smashsmashin/ROTAX-CAN-decoder/hw/BRP-RotaxEngineDecoder.kicad_sch

## KiCad design hw/BRP-RotaxEngineDecoder.kicad_sch (2025-06-22)

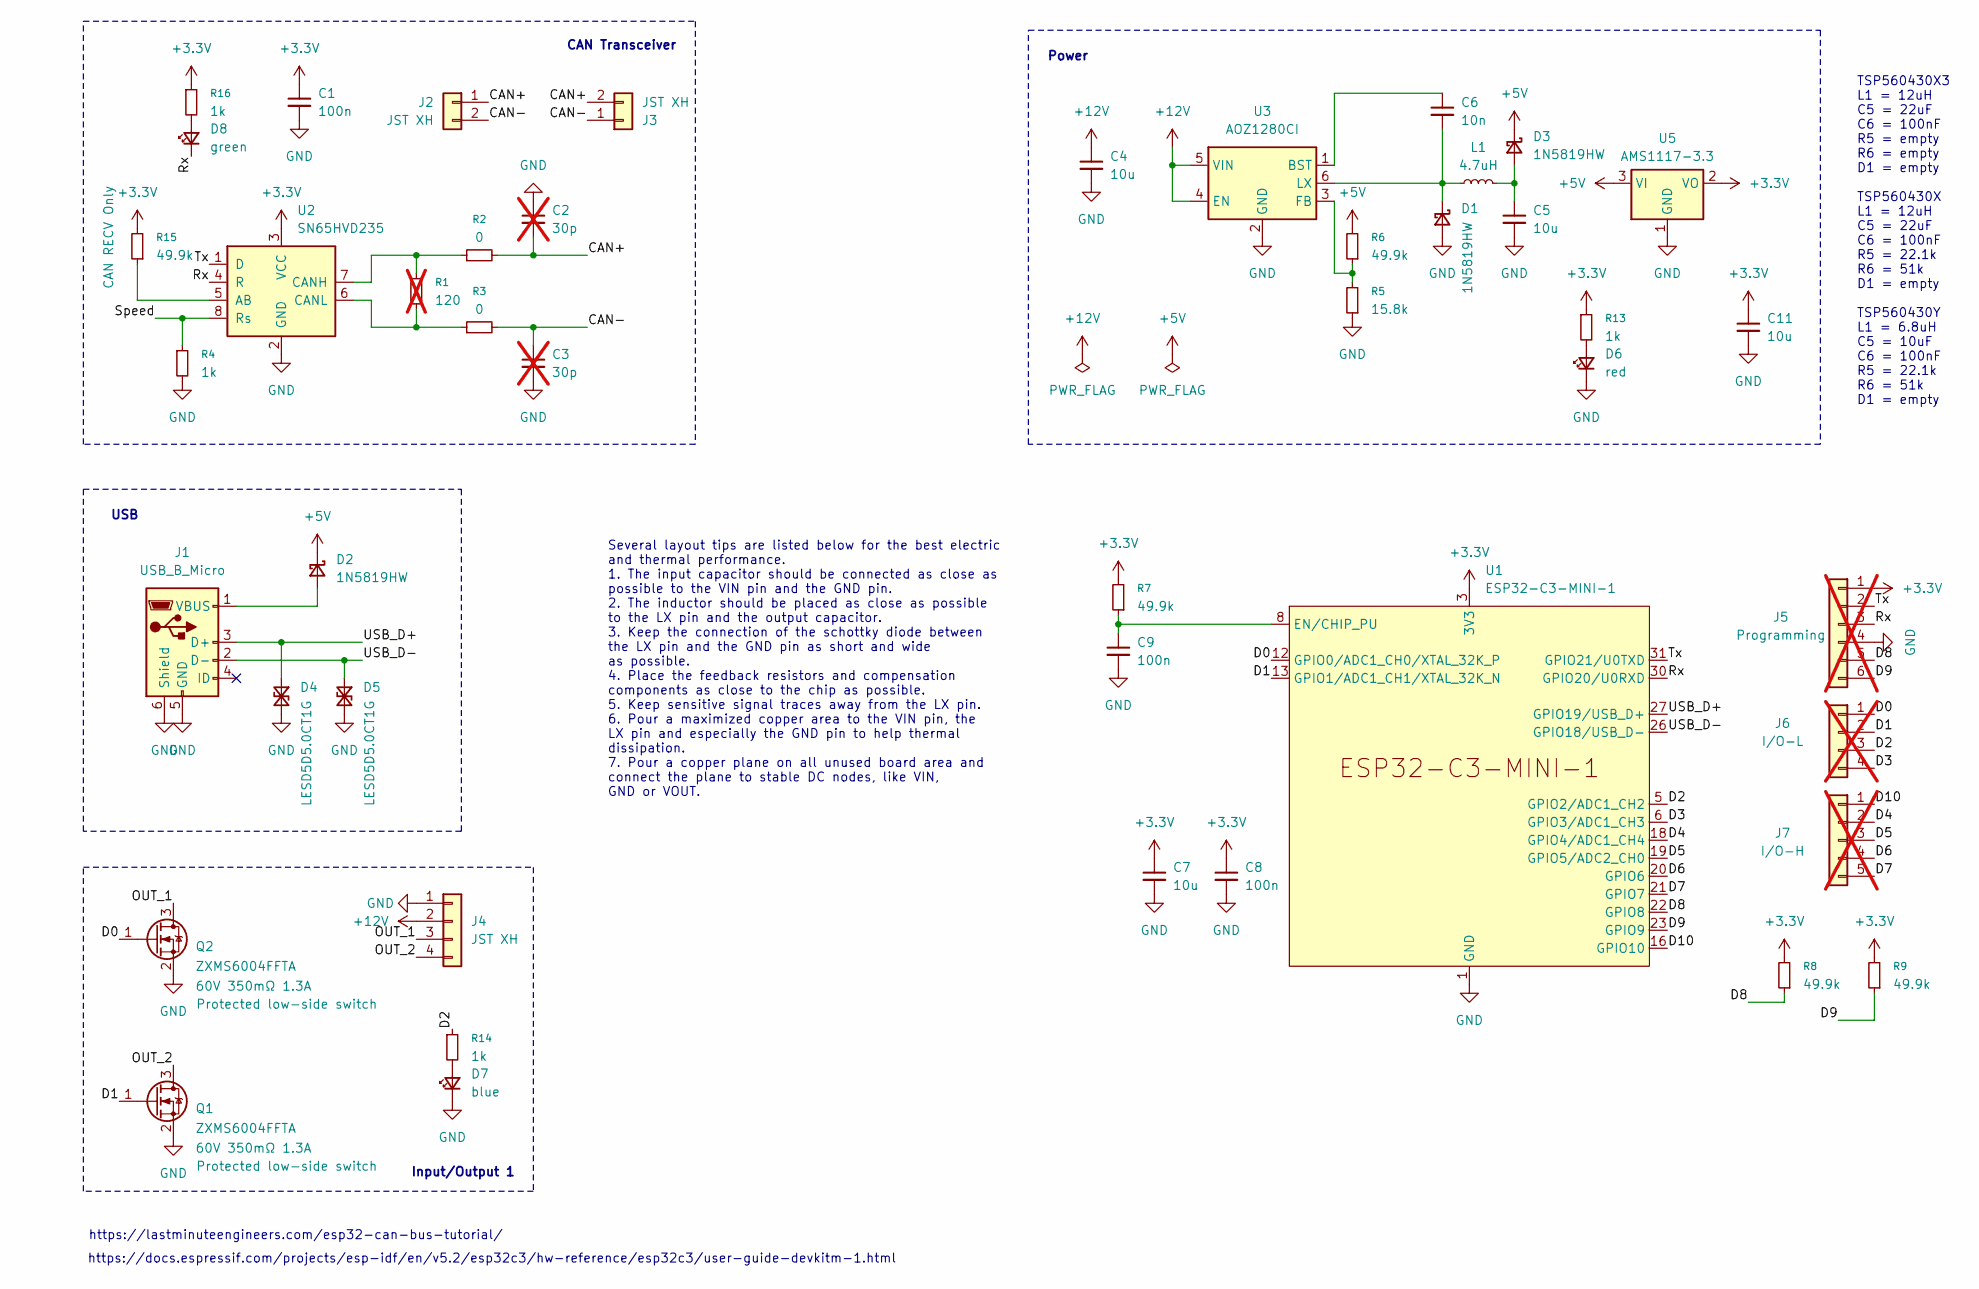
[picture p1: schematic BRP-RotaxEngineDecoder.kicad_sch]

Parts:
C1, C8: 100n; C_0603_1608Metric
C2, C3: 30p; C_0402_1005Metric; not fitted
C4, C5, C7, C11: 10u; C_0603_1608Metric
C6: 10n; C_0603_1608Metric
C9: 100n; C_0402_1005Metric
D1, D2, D3: 1N5819HW; D_SOD-123
D4, D5: LESD5D5.0CT1G; D_SOD-523
D6: red; LED_0603_1608Metric
D7: blue; LED_0603_1608Metric
D8: green; LED_0603_1608Metric
J1: USB_B_Micro; USB_Micro-B_Molex-105017-0001
J2, J3: JST XH; JST_XH_S2B-XH-A-1_1x02_P2.50mm_Horizontal
J4: JST XH; JST_XH_S4B-XH-A-1_1x04_P2.50mm_Horizontal
J5: Programming; PinHeader_1x06_P1.27mm_Vertical; not fitted
J6: I/O-L; PinHeader_1x04_P1.27mm_Vertical; not fitted
J7: I/O-H; PinHeader_1x05_P1.27mm_Vertical; not fitted
L1: 4.7uH; L_1008_2520Metric
Q1, Q2: ZXMS6004FFTA; SOT-23
R1: 120; R_0603_1608Metric; not fitted
R2, R3: 0; R_0603_1608Metric
R4, R13, R14, R16: 1k; R_0603_1608Metric
R5: 15.8k; R_0603_1608Metric
R6, R8, R9, R15: 49.9k; R_0603_1608Metric
R7: 49.9k; R_0402_1005Metric
U1: ESP32-C3-MINI-1
U2: SN65HVD235; SOIC-8_3.9x4.9mm_P1.27mm
U3: AOZ1280CI; SOT-23-6
U5: AMS1117-3.3; SOT-89-3

Connections:
+3.3V: C1.1, C7.1, C8.1, C11.1, J5.1, R7.2, R8.2, R9.2, R13.1, R15.2, R16.1, U1.3 (3V3), U2.3 (VCC), U5.2 (VO)
+5V: D2.1 (K), D3.1 (K), R6.2, U5.3 (VI)
+12V: C4.1, J4.2, U3.4 (EN), U3.5 (VIN)
CAN+: C2.2, J2.1, J3.2, R2.2
CAN-: C3.1, J2.2, J3.1, R3.2
D0: J6.1, Q2.1 (G), U1.12 (GPIO0/ADC1_CH0/XTAL_32K_P)
D1: J6.2, Q1.1 (G), U1.13 (GPIO1/ADC1_CH1/XTAL_32K_N)
D2: J6.3, R14.1, U1.5 (GPIO2/ADC1_CH2)
D3: J6.4, U1.6 (GPIO3/ADC1_CH3)
D4: J7.2, U1.18 (GPIO4/ADC1_CH4)
D5: J7.3, U1.19 (GPIO5/ADC2_CH0)
D6: J7.4, U1.20 (GPIO6)
D7: J7.5, U1.21 (GPIO7)
D8: J5.5, R8.1, U1.22 (GPIO8)
D9: J5.6, R9.1, U1.23 (GPIO9)
D10: J7.1, U1.16 (GPIO10)
GND: C1.2, C2.1, C3.2, C4.2, C5.2, C7.2, C8.2, C9.2, C11.2, D1.2 (A), D4.2 (A2), D5.2 (A2), D6.1 (K), D7.1 (K), J1.5 (GND), J1.6 (Shield), J4.1, J5.4, Q1.2 (S), Q2.2 (S), R4.2, R5.1, U1.1 (GND), U1.2 (GND), U1.11 (GND), U1.14 (GND), U1.36 (GND), U1.37 (GND), U1.38 (GND), U1.39 (GND), U1.40 (GND), U1.41 (GND), U1.42 (GND), U1.43 (GND), U1.44 (GND), U1.45 (GND), U1.46 (GND), U1.47 (GND), U1.48 (GND), U1.49 (GND), U1.50 (GND), U1.51 (GND), U1.52 (GND), U1.53 (GND), U2.2 (GND), U3.2 (GND), U5.1 (GND)
unnamed: C5.1, D3.2 (A), L1.2
unnamed: C6.1, U3.1 (BST)
unnamed: C6.2, D1.1 (K), L1.1, U3.6 (LX)
unnamed: C9.1, R7.1, U1.8 (EN/CHIP_PU)
unnamed: D2.2 (A), J1.1 (VBUS)
unnamed: D6.2 (A), R13.2
unnamed: D7.2 (A), R14.2
unnamed: D8.2 (A), R16.2
unnamed: R1.1, R2.1, U2.7 (CANH)
unnamed: R1.2, R3.1, U2.6 (CANL)
unnamed: R5.2, R6.1, U3.3 (FB)
unnamed: R15.1, U2.5 (AB)
OUT_1: J4.3, Q2.3 (D)
OUT_2: J4.4, Q1.3 (D)
Rx: D8.1 (K), J5.3, U1.30 (GPIO20/U0RXD), U2.4 (R)
Speed: R4.1, U2.8 (Rs)
Tx: J5.2, U1.31 (GPIO21/U0TXD), U2.1 (D)
USB_D+: D4.1 (A1), J1.3 (D+), U1.27 (GPIO19/USB_D+)
USB_D-: D5.1 (A1), J1.2 (D-), U1.26 (GPIO18/USB_D-)

Notes on the sheet:
CAN Transceiver
https://docs.espressif.com/projects/esp-idf/en/v5.2/esp32c3/hw-reference/esp32c3/user-guide-devkitm-1.html
Power
Input/Output 1
USB
https://lastminuteengineers.com/esp32-can-bus-tutorial/
TSP560430X3 L1 = 12uH C5 = 22uF C6 = 100nF R5 = empty R6 = empty D1 = empty TSP560430X L1 = 12uH C5 = 22uF C6 = 100nF R5 = 22.1k R6 = 51k D1 = empty TSP560430Y L1 = 6.8uH C5 = 10uF C6 = 100nF R5 = 22.1k R6 = 51k D1 = empty
Several layout tips are listed below for the best electric and thermal performance. 1. The input capacitor should be connected as close as possible to the VIN pin and the GND pin. 2. The inductor should be placed as close as possible to the LX pin and the output capacitor. 3. Keep the connection of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
