smashsmashin/ROTAX-CAN-decoder/(commit log)

2025-07-20 feat: Implement ESP32-C3 CAN logger (#1)
    * feat: Implement ESP32-C3 CAN logger
    This commit introduces a firmware application for an ESP32-C3 microcontroller
    to initialize and log CAN bus packets to the USB serial output.
    Key features:
    - Initializes CAN controller with GPIO21 (TX) and GPIO20 (RX).
    - Configured for 500kbps baud rate (configurable).
    - Logs received CAN message ID, DLC, and data payload.
    - Implements basic error handling for CAN driver setup.
    - Includes status LED indication (GPIO2) for:
    - Initialization failure (fast blink)
    - Normal operation (LED OFF)
    - CAN bus-off state (LED ON)
    - Bus recovery attempts (LED ON)
    - Project structured for ESP-IDF build system.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
    [can_logger.c]
2025-07-20 feat: Change CAN bus speed to 125k (#2)
2025-07-26 Fix/final economy mode logic (#3)
    * Added ROTAX CAN documentation
    * fix: Correct bitmask and logic for economy mode detection
    This commit corrects the bitmask and logic for parsing CANaerospace packets to accurately determine the engine's economy or power mode.
    The following corrections have been made:
    - The bitmask has been corrected to 0x02 to properly check Bit 2.
    - The logic has been updated to correctly map the bit value to the engine mode:
    - 0: Power Mode (OUT_1: inactive, OUT_2: active)
    - 1: Economy Mode (OUT_1: active, OUT_2: inactive)
    - A check for the BLONG data type (type 5) has been included.
    - The correct byte (index 7) is now being checked for the mode.
    - The GPIOs are n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
    [can_logger.c]
